rah1236/PCBGolf/pcbgolf.kicad_sch

## KiCad design pcbgolf.kicad_sch (2026-09-24)

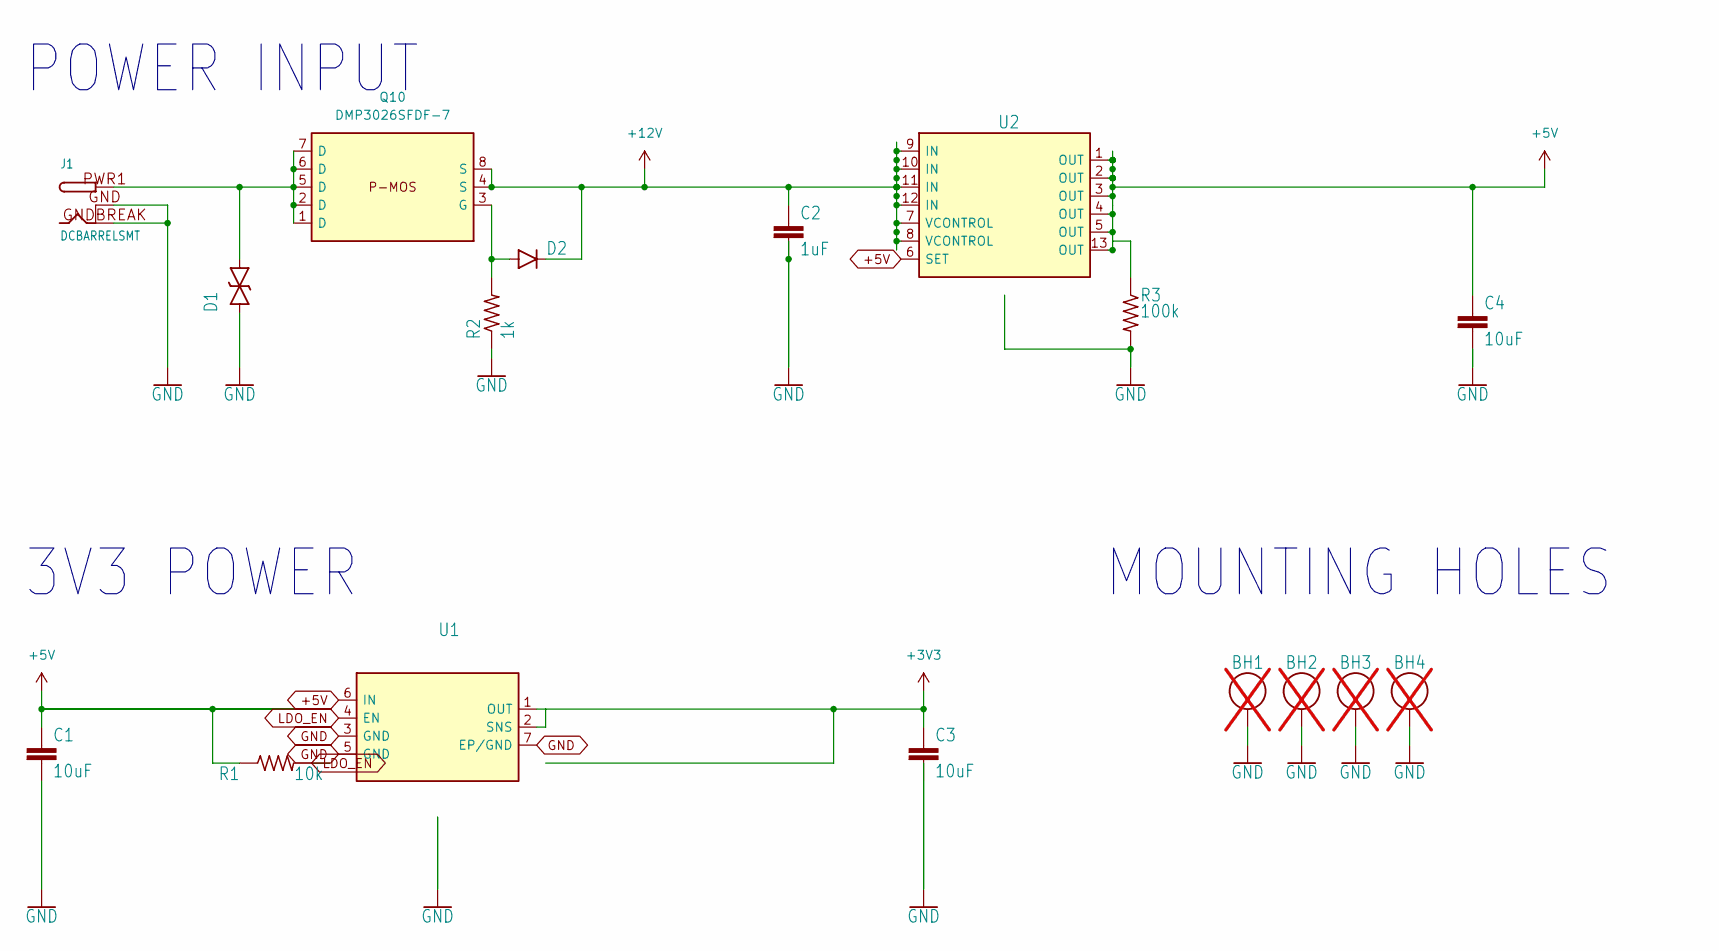
[picture p1: schematic pcbgolf.kicad_sch]

Parts:
BH1, BH2, BH3, BH4: M2_BOLT; not fitted
C1, C3, C4: 10uF; 0805-C; MPN CL21A106KAYNNNE
C2: 1uF; 0805-C; MPN CL21A106KAYNNNE
D1: TVS-BI-DO214AA; DO-214AA(SMB); MPN SMAJ16CA-13-F
D2: DIODEDB2W40100L; SOD-123F; MPN PMEG10020ELRX
J1: DCBARRELSMT; DCJACK_2MM_SMT; MPN PJ-002AH-SMT-TR
Q10: DMP3026SFDF-7; DMP3026SFDF-7_U-DFN2020-6; MPN DMP3026SFDF-7; LCSC Part C461076
R1: 10k; 0402-R; MPN RC0402FR-0710KL
R2: 1k; 0402-R; MPN RC0402JR-071KL
R3: 100k; 0402-R; MPN RC0100FR-07100KL
U1: TLV76733DRVR; WSON-6_L2.0-W2.0-P0.65-TL-EP; MPN TLV76733DRVR; LCSC Part C2848334
U2: LT3083IDF#TRPBF; DFN-12_L4.0-W4.0-P0.50-BL-EP; MPN LT3083IDF#TRPBF; LCSC Part C670355

Connections:
+3V3: C3.1, U1.1 (OUT), U1.2 (SNS)
+5V: C1.1, C4.1, R1.1, R3.1, U1.6 (IN), U2.1 (OUT), U2.2 (OUT), U2.3 (OUT), U2.4 (OUT), U2.5 (OUT), U2.6 (SET), U2.13 (OUT)
+12V: C2.1, D2.1 (C), Q10.4 (S), Q10.8 (S), U2.7 (VCONTROL), U2.8 (VCONTROL), U2.9 (IN), U2.10 (IN), U2.11 (IN), U2.12 (IN)
GND: BH1.0, BH2.0, BH3.0, BH4.0, C1.2, C2.2, C3.2, C4.2, D1.1, J1.GND (GNDBREAK), J1.GNDBREAK (GND), R2.1, R3.2, U1.3 (GND), U1.5 (GND), U1.7 (EP/GND)
LDO_EN: R1.2, U1.4 (EN)
unnamed: D1.2, J1.PWR1 (PWR), Q10.1 (D), Q10.2 (D), Q10.5 (D), Q10.6 (D), Q10.7 (D)
unnamed: D2.2 (A), Q10.3 (G), R2.2

Notes on the sheet:
MOUNTING HOLES
3V3 POWER
POWER INPUT
