rah1236/PCBGolf/pcbgolf_2.kicad_sch

## KiCad design pcbgolf_2.kicad_sch (2026-09-24)

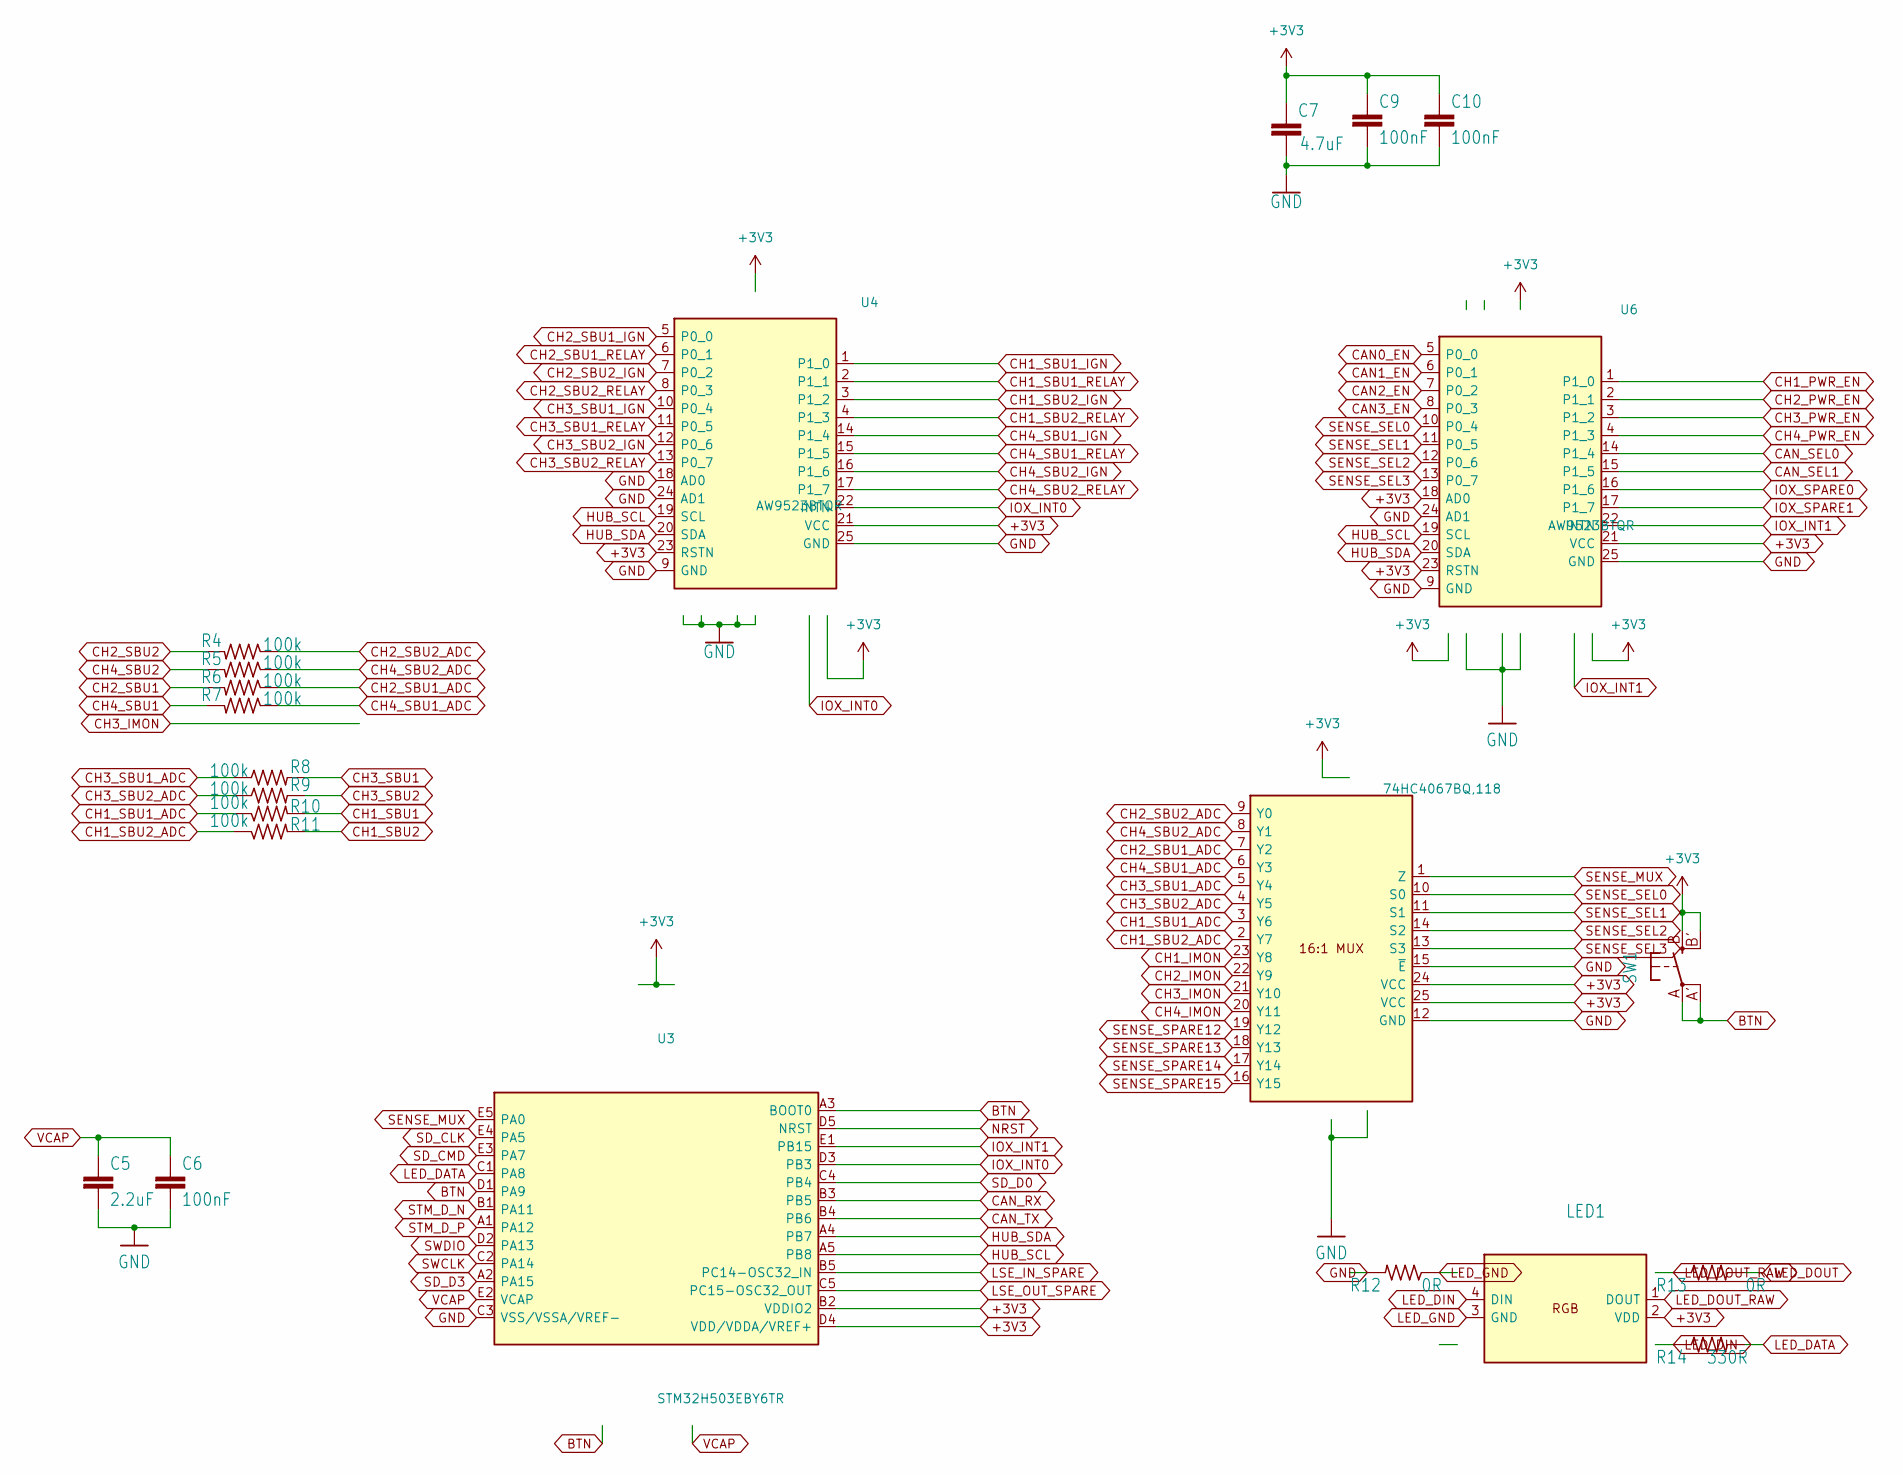
[picture p2: schematic pcbgolf_2.kicad_sch]

Parts:
C5: 2.2uF; 0805-C; MPN CL21A106KAYNNNE
C6, C9, C10: 100nF; 0402-C; MPN CL05F104ZO5NNNC
C7: 4.7uF; 0805-C; MPN CL21A106KAYNNNE
LED1: XL-1010RGBC-WS2812B; LED-SMD_4P-L1.0-W1.0-TL_XL-1010RGBC-WS2812B; MPN XL-1010RGBC-2812B; LCSC Part C5349953
R4, R5, R6, R7, R8, R9, R10, R11: 100k; 0402-R; MPN RC0402JR-07100KL
R12, R13: 0R; 0402-R; MPN RC0100JR-070RL
R14: 330R; 0402-R; MPN RC0100FR-07330RL
SW1: SPST-2-4PIN; EVQ-Q2; MPN EVQ-Q2Y03W
U3: STM32H503EBY6TR; WLCSP-25_L2.3-W2.2-R5-C5-P0.40-BR; MPN STM32H503EBY6TR; LCSC Part C26803530
U4, U6: AW9523BTQR; VFQFPN-24_L4.0-W4.0-P0.50-BL-EP2.8; MPN AW9523BTQR; LCSC Part C148077
U5: 74HC4067BQ,118; DHVQFN24_L5.5-W3.5-P0.50-BL-EP; MPN 74HC4067BQ,118; LCSC Part C547033

Connections:
+3V3: C7.1, C9.1, C10.1, LED1.2 (VDD), SW1.B (S), SW1.B' (S1), U3.B2 (VDDIO2), U3.D4 (VDD/VDDA/VREF+), U4.21 (VCC), U4.23 (RSTN), U5.24 (VCC), U5.25 (VCC), U6.18 (AD0), U6.21 (VCC), U6.23 (RSTN)
BTN: SW1.A, SW1.A' (P1), U3.A3 (BOOT0), U3.D1 (PA9)
CAN0_EN: U6.5 (P0_0)
CAN1_EN: U6.6 (P0_1)
CAN2_EN: U6.7 (P0_2)
CAN3_EN: U6.8 (P0_3)
CAN_RX: U3.B3 (PB5)
CAN_SEL0: U6.14 (P1_4)
CAN_SEL1: U6.15 (P1_5)
CAN_TX: U3.B4 (PB6)
CH1_IMON: U5.23 (Y8)
CH1_PWR_EN: U6.1 (P1_0)
CH1_SBU1: R10.2
CH1_SBU1_ADC: R10.1, U5.3 (Y6)
CH1_SBU1_IGN: U4.1 (P1_0)
CH1_SBU1_RELAY: U4.2 (P1_1)
CH1_SBU2: R11.2
CH1_SBU2_ADC: R11.1, U5.2 (Y7)
CH1_SBU2_IGN: U4.3 (P1_2)
CH1_SBU2_RELAY: U4.4 (P1_3)
CH2_IMON: U5.22 (Y9)
CH2_PWR_EN: U6.2 (P1_1)
CH2_SBU1: R6.2
CH2_SBU1_ADC: R6.1, U5.7 (Y2)
CH2_SBU1_IGN: U4.5 (P0_0)
CH2_SBU1_RELAY: U4.6 (P0_1)
CH2_SBU2: R4.2
CH2_SBU2_ADC: R4.1, U5.9 (Y0)
CH2_SBU2_IGN: U4.7 (P0_2)
CH2_SBU2_RELAY: U4.8 (P0_3)
CH3_IMON: U5.21 (Y10)
CH3_PWR_EN: U6.3 (P1_2)
CH3_SBU1: R8.2
CH3_SBU1_ADC: R8.1, U5.5 (Y4)
CH3_SBU1_IGN: U4.10 (P0_4)
CH3_SBU1_RELAY: U4.11 (P0_5)
CH3_SBU2: R9.2
CH3_SBU2_ADC: R9.1, U5.4 (Y5)
CH3_SBU2_IGN: U4.12 (P0_6)
CH3_SBU2_RELAY: U4.13 (P0_7)
CH4_IMON: U5.20 (Y11)
CH4_PWR_EN: U6.4 (P1_3)
CH4_SBU1: R7.2
CH4_SBU1_ADC: R7.1, U5.6 (Y3)
CH4_SBU1_IGN: U4.14 (P1_4)
CH4_SBU1_RELAY: U4.15 (P1_5)
CH4_SBU2: R5.2
CH4_SBU2_ADC: R5.1, U5.8 (Y1)
CH4_SBU2_IGN: U4.16 (P1_6)
CH4_SBU2_RELAY: U4.17 (P1_7)
GND: C5.2, C6.2, C7.2, C9.2, C10.2, R12.2, U3.C3 (VSS/VSSA/VREF-), U4.9 (GND), U4.18 (AD0), U4.24 (AD1), U4.25 (GND), U5.12 (GND), U5.15 (~E), U6.9 (GND), U6.24 (AD1), U6.25 (GND)
HUB_SCL: U3.A5 (PB8), U4.19 (SCL), U6.19 (SCL)
HUB_SDA: U3.A4 (PB7), U4.20 (SDA), U6.20 (SDA)
IOX_INT0: U3.D3 (PB3), U4.22 (INTN)
IOX_INT1: U3.E1 (PB15), U6.22 (INTN)
IOX_SPARE0: U6.16 (P1_6)
IOX_SPARE1: U6.17 (P1_7)
LED_DATA: R14.2, U3.C1 (PA8)
LED_DIN: LED1.4 (DIN), R14.1
LED_DOUT: R13.2
LED_DOUT_RAW: LED1.1 (DOUT), R13.1
LED_GND: LED1.3 (GND), R12.1
LSE_IN_SPARE: U3.B5 (PC14-OSC32_IN)
LSE_OUT_SPARE: U3.C5 (PC15-OSC32_OUT)
NRST: U3.D5 (NRST)
SD_CLK: U3.E4 (PA5)
SD_CMD: U3.E3 (PA7)
SD_D0: U3.C4 (PB4)
SD_D3: U3.A2 (PA15)
SENSE_MUX: U3.E5 (PA0), U5.1 (Z)
SENSE_SEL0: U5.10 (S0), U6.10 (P0_4)
SENSE_SEL1: U5.11 (S1), U6.11 (P0_5)
SENSE_SEL2: U5.14 (S2), U6.12 (P0_6)
SENSE_SEL3: U5.13 (S3), U6.13 (P0_7)
SENSE_SPARE12: U5.19 (Y12)
SENSE_SPARE13: U5.18 (Y13)
SENSE_SPARE14: U5.17 (Y14)
SENSE_SPARE15: U5.16 (Y15)
STM_D_N: U3.B1 (PA11)
STM_D_P: U3.A1 (PA12)
SWCLK: U3.C2 (PA14)
SWDIO: U3.D2 (PA13)
VCAP: C5.1, C6.1, U3.E2 (VCAP)
