rah1236/PCBGolf/pcbgolf_3.kicad_sch

## KiCad design pcbgolf_3.kicad_sch (2026-09-24)

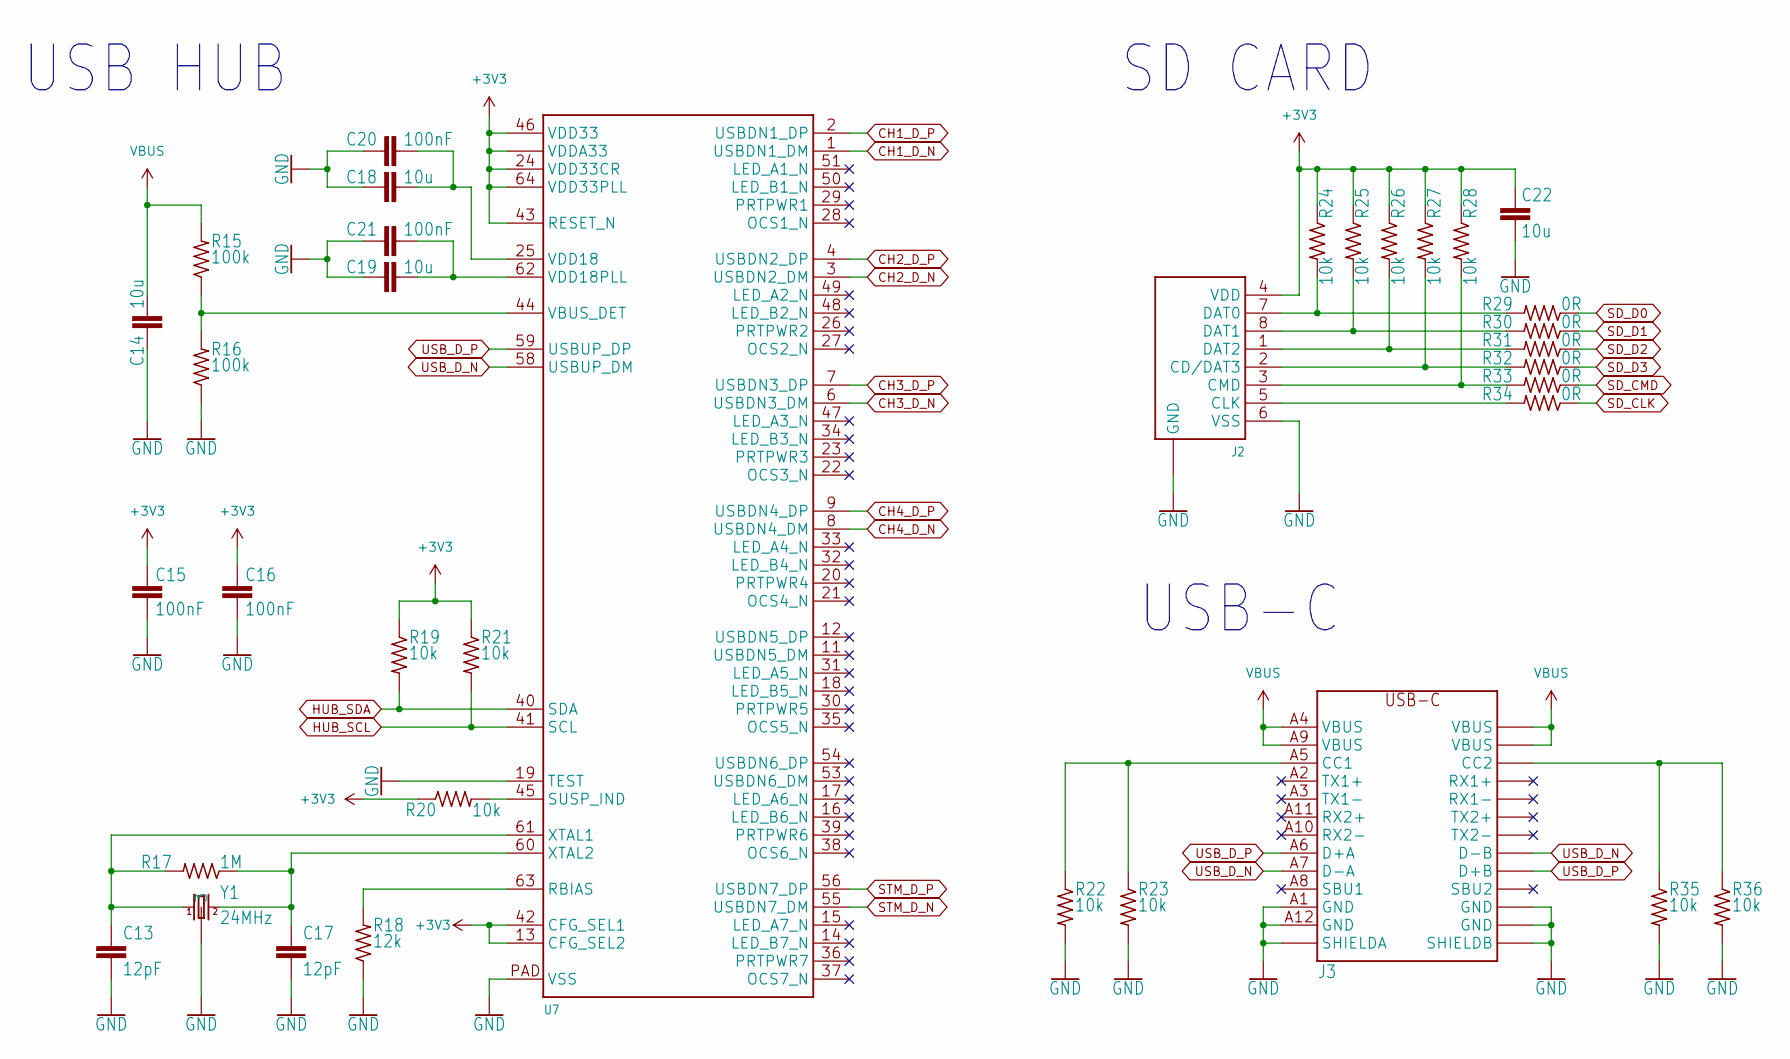
[picture p3: schematic pcbgolf_3.kicad_sch]

Parts:
C13, C17: 12pF; 0402-C; MPN C0402C120J5GACTU
C14, C18, C19, C22: 10u; 0402-C; MPN GRM155R61A106ME11D
C15, C16, C20, C21: 100nF; 0402-C; MPN CL05F104ZO5NNNC
J2: MICRO_SD-0472192001; 0472192001; MPN 47219-2001
J3: USB-C-FEMALE; DX07S024XJ1R1100; MPN DX07S024XJ1R1100
R15, R16: 100k; 0402-R; MPN RC0402JR-07100KL
R17: 1M; 0402-R; MPN RC0402JR-071ML
R18: 12k; 0402-R; MPN CRGCQ0402F12K
R19, R20, R21, R22, R23, R24, R25, R26, R27, R28, R35, R36: 10k; 0402-R; MPN RC0402FR-0710KL
R29, R30, R31, R32, R33, R34: 0R; 0402-R; MPN RMCF0402ZT0R00
U7: USB2517; QFN64-9X9; MPN USB2517
Y1: 24MHz; XTAL-3.2X2.5; MPN ABM8AIG-24.000MHZ-12-2Z-T3

Connections:
+3V3: C15.2, C16.2, C22.1, J2.4 (VDD), R19.1, R20.1, R21.1, R24.1, R25.1, R26.1, R27.1, R28.1, U7.5 (VDDA33), U7.10 (VDDA33), U7.13 (CFG_SEL2), U7.24 (VDD33CR), U7.42 (CFG_SEL1), U7.43 (RESET_N), U7.46 (VDD33), U7.52 (VDDA33), U7.57 (VDDA33), U7.64 (VDD33PLL)
CH1_D_N: U7.1 (USBDN1_DM)
CH1_D_P: U7.2 (USBDN1_DP)
CH2_D_N: U7.3 (USBDN2_DM)
CH2_D_P: U7.4 (USBDN2_DP)
CH3_D_N: U7.6 (USBDN3_DM)
CH3_D_P: U7.7 (USBDN3_DP)
CH4_D_N: U7.8 (USBDN4_DM)
CH4_D_P: U7.9 (USBDN4_DP)
GND: C13.2, C14.2, C15.1, C16.1, C17.2, C18.2, C19.2, C20.1, C21.1, C22.2, J2.6 (VSS), J2.G1 (GND), J2.G2 (GND), J2.G3 (GND), J2.G4 (GND), J3.A1 (GND), J3.A12 (GND), J3.B1 (GND), J3.B1T (GND), J3.B12 (GND), J3.B12T (GND), J3.S1B (SHIELDA), J3.S1T (SHIELDA), J3.S1TH (SHIELDA), J3.S2B (SHIELDA), J3.S2T (SHIELDA), J3.S2TH (SHIELDA), J3.S3B (SHIELDB), J3.S3T (SHIELDB), J3.S3TH (SHIELDB), J3.S4B (SHIELDB), J3.S4T (SHIELDB), J3.S4TH (SHIELDB), R16.1, R18.1, R22.2, R23.2, R35.2, R36.2, U7.19 (TEST), U7.PAD (VSS), Y1.2 (3), Y1.4 (3)
HUB_SCL: R21.2, U7.41 (SCL)
HUB_SDA: R19.2, U7.40 (SDA)
unnamed: C13.1, R17.2, U7.61 (XTAL1), Y1.1
unnamed: C17.1, R17.1, U7.60 (XTAL2), Y1.3 (2)
unnamed: C18.1, C20.2, U7.25 (VDD18)
unnamed: C19.1, C21.2, U7.62 (VDD18PLL)
unnamed: J2.1 (DAT2), R26.2, R31.2
unnamed: J2.2 (CD/DAT3), R27.2, R32.2
unnamed: J2.3 (CMD), R28.2, R33.2
unnamed: J2.5 (CLK), R34.2
unnamed: J2.7 (DAT0), R24.2, R29.2
unnamed: J2.8 (DAT1), R25.2, R30.2
unnamed: J3.A5 (CC1), R22.1, R23.1
unnamed: J3.B2 (TX2+), J3.B2T (TX2+)
unnamed: J3.B3 (TX2-), J3.B3T (TX2-)
unnamed: J3.B5 (CC2), J3.B5T (CC2), R35.1, R36.1
unnamed: J3.B8 (SBU2), J3.B8T (SBU2)
unnamed: J3.B10 (RX1-), J3.B10T (RX1-)
unnamed: J3.B11 (RX1+), J3.B11T (RX1+)
unnamed: R15.1, R16.2, U7.44 (VBUS_DET)
unnamed: R18.2, U7.63 (RBIAS)
unnamed: R20.2, U7.45 (SUSP_IND)
SD_CLK: R34.1
SD_CMD: R33.1
SD_D0: R29.1
SD_D1: R30.1
SD_D2: R31.1
SD_D3: R32.1
STM_D_N: U7.55 (USBDN7_DM)
STM_D_P: U7.56 (USBDN7_DP)
USB_D_N: J3.A7 (D-A), J3.B7 (D-B), J3.B7T (D-B), U7.58 (USBUP_DM)
USB_D_P: J3.A6 (D+A), J3.B6 (D+B), J3.B6T (D+B), U7.59 (USBUP_DP)
VBUS: C14.1, J3.A4 (VBUS), J3.A9 (VBUS), J3.B4 (VBUS), J3.B4T (VBUS), J3.B9 (VBUS), J3.B9T (VBUS), R15.2

Notes on the sheet:
SD CARD
USB-C
USB HUB
