rah1236/PCBGolf/pcbgolf_4.kicad_sch

## KiCad design pcbgolf_4.kicad_sch (2026-09-24)

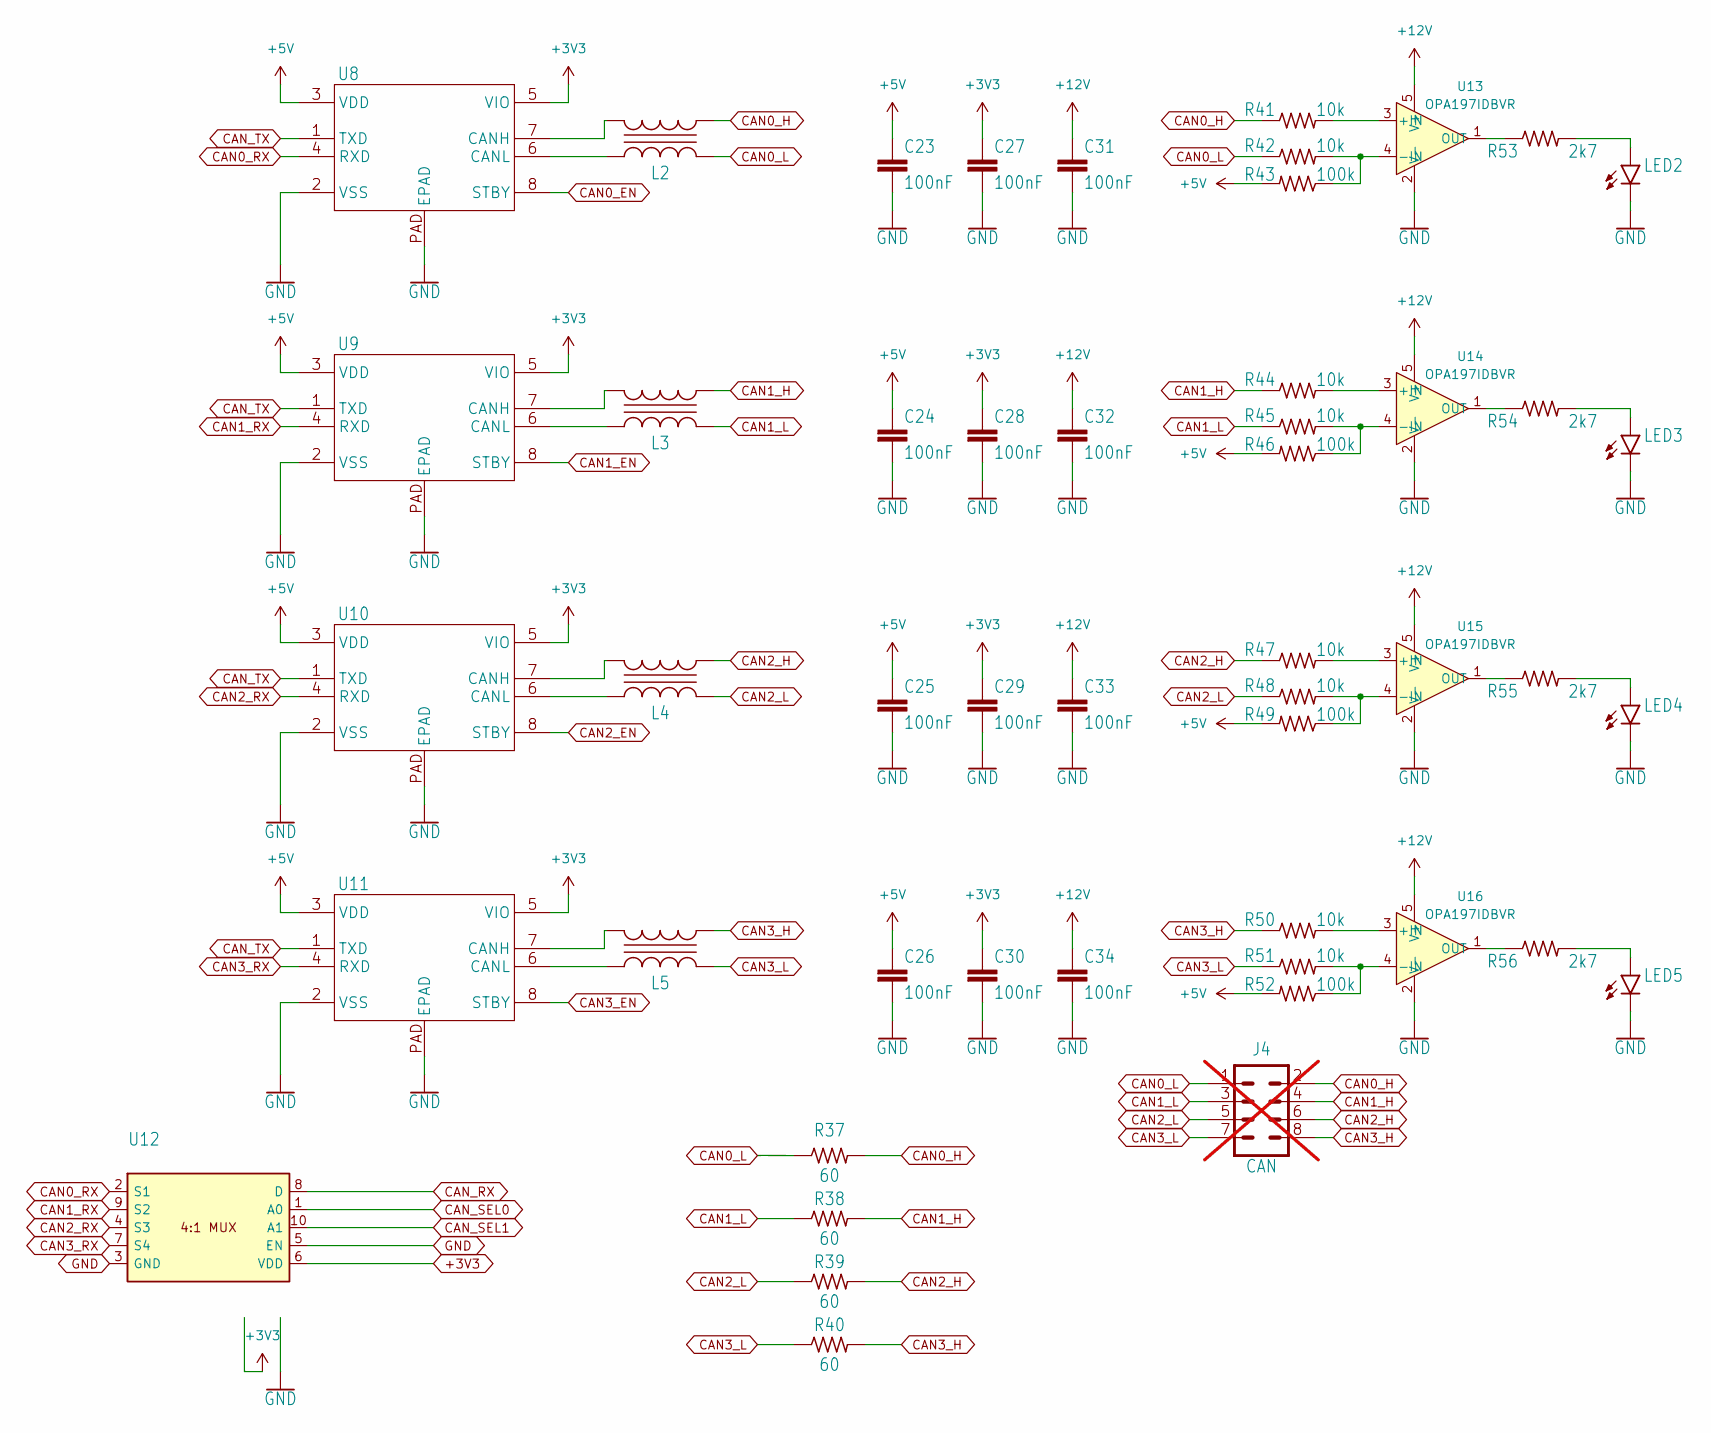
[picture p4: schematic pcbgolf_4.kicad_sch]

Parts:
C23, C24, C25, C26, C27, C28, C29, C30, C31, C32, C33, C34: 100nF; 0402-C; MPN CL05F104ZO5NNNC
J4: CAN; 2X04; not fitted
L2, L3, L4, L5: ACT1210D_CHOKE; CHOKE-3.2X2.5; MPN ACT1210D-101-2P-TL00
LED2, LED3, LED4, LED5: APG015ZGC/S-5MAV; Kingbright_APG015_01005; MPN APG015ZGC/S-5MAV
R37, R38, R39, R40: 60; 0402-R; MPN RC0402FR-0760R4L
R41, R42, R44, R45, R47, R48, R50, R51: 10k; 0402-R; MPN RC0402FR-0710KL
R43, R46, R49, R52: 100k; 0402-R; MPN RC0402JR-07100KL
R53, R54, R55, R56: 2k7; 0402-R; MPN RC0402JR-072K7L
U8, U9, U10, U11: MCP2542FDT-E/MNY; TDFN8_2X3MC_MCH; MPN MCP2542FDT-H/MNY
U12: TMUX1204DQAR; USON-10_L2.5-W1.0-P0.50-BL; MPN TMUX1204DQAR; LCSC Part C1849379
U13, U14, U15, U16: OPA197IDBVR; SOT23-5; MPN OPA197IDBVR

Connections:
+3V3: C27.1, C28.1, C29.1, C30.1, U8.5 (VIO), U9.5 (VIO), U10.5 (VIO), U11.5 (VIO), U12.6 (VDD)
+5V: C23.1, C24.1, C25.1, C26.1, R43.2, R46.2, R49.2, R52.2, U8.3 (VDD), U9.3 (VDD), U10.3 (VDD), U11.3 (VDD)
+12V: C31.1, C32.1, C33.1, C34.1, U13.5 (V+), U14.5 (V+), U15.5 (V+), U16.5 (V+)
CAN0_EN: U8.8 (STBY)
CAN0_H: J4.2, L2.4, R37.2, R41.1
CAN0_L: J4.1, L2.3, R37.1, R42.1
CAN0_RX: U8.4 (RXD), U12.2 (S1)
CAN1_EN: U9.8 (STBY)
CAN1_H: J4.4, L3.4, R38.2, R44.1
CAN1_L: J4.3, L3.3, R38.1, R45.1
CAN1_RX: U9.4 (RXD), U12.9 (S2)
CAN2_EN: U10.8 (STBY)
CAN2_H: J4.6, L4.4, R39.2, R47.1
CAN2_L: J4.5, L4.3, R39.1, R48.1
CAN2_RX: U10.4 (RXD), U12.4 (S3)
CAN3_EN: U11.8 (STBY)
CAN3_H: J4.8, L5.4, R40.2, R50.1
CAN3_L: J4.7, L5.3, R40.1, R51.1
CAN3_RX: U11.4 (RXD), U12.7 (S4)
CAN_RX: U12.8 (D)
CAN_SEL0: U12.1 (A0)
CAN_SEL1: U12.10 (A1)
CAN_TX: U8.1 (TXD), U9.1 (TXD), U10.1 (TXD), U11.1 (TXD)
GND: C23.2, C24.2, C25.2, C26.2, C27.2, C28.2, C29.2, C30.2, C31.2, C32.2, C33.2, C34.2, LED2.1 (K), LED3.1 (K), LED4.1 (K), LED5.1 (K), U8.2 (VSS), U8.PAD (EPAD), U9.2 (VSS), U9.PAD (EPAD), U10.2 (VSS), U10.PAD (EPAD), U11.2 (VSS), U11.PAD (EPAD), U12.3 (GND), U12.5 (EN), U13.2 (V-), U14.2 (V-), U15.2 (V-), U16.2 (V-)
unnamed: L2.1, U8.7 (CANH)
unnamed: L2.2, U8.6 (CANL)
unnamed: L3.1, U9.7 (CANH)
unnamed: L3.2, U9.6 (CANL)
unnamed: L4.1, U10.7 (CANH)
unnamed: L4.2, U10.6 (CANL)
unnamed: L5.1, U11.7 (CANH)
unnamed: L5.2, U11.6 (CANL)
unnamed: LED2.2 (A), R53.2
unnamed: LED3.2 (A), R54.2
unnamed: LED4.2 (A), R55.2
unnamed: LED5.2 (A), R56.2
unnamed: R41.2, U13.3 (+IN)
unnamed: R42.2, R43.1, U13.4 (-IN)
unnamed: R44.2, U14.3 (+IN)
unnamed: R45.2, R46.1, U14.4 (-IN)
unnamed: R47.2, U15.3 (+IN)
unnamed: R48.2, R49.1, U15.4 (-IN)
unnamed: R50.2, U16.3 (+IN)
unnamed: R51.2, R52.1, U16.4 (-IN)
unnamed: R53.1, U13.1 (OUT)
unnamed: R54.1, U14.1 (OUT)
unnamed: R55.1, U15.1 (OUT)
unnamed: R56.1, U16.1 (OUT)
