rah1236/PCBGolf/pcbgolf_5.kicad_sch

## KiCad design pcbgolf_5.kicad_sch (2026-09-24)

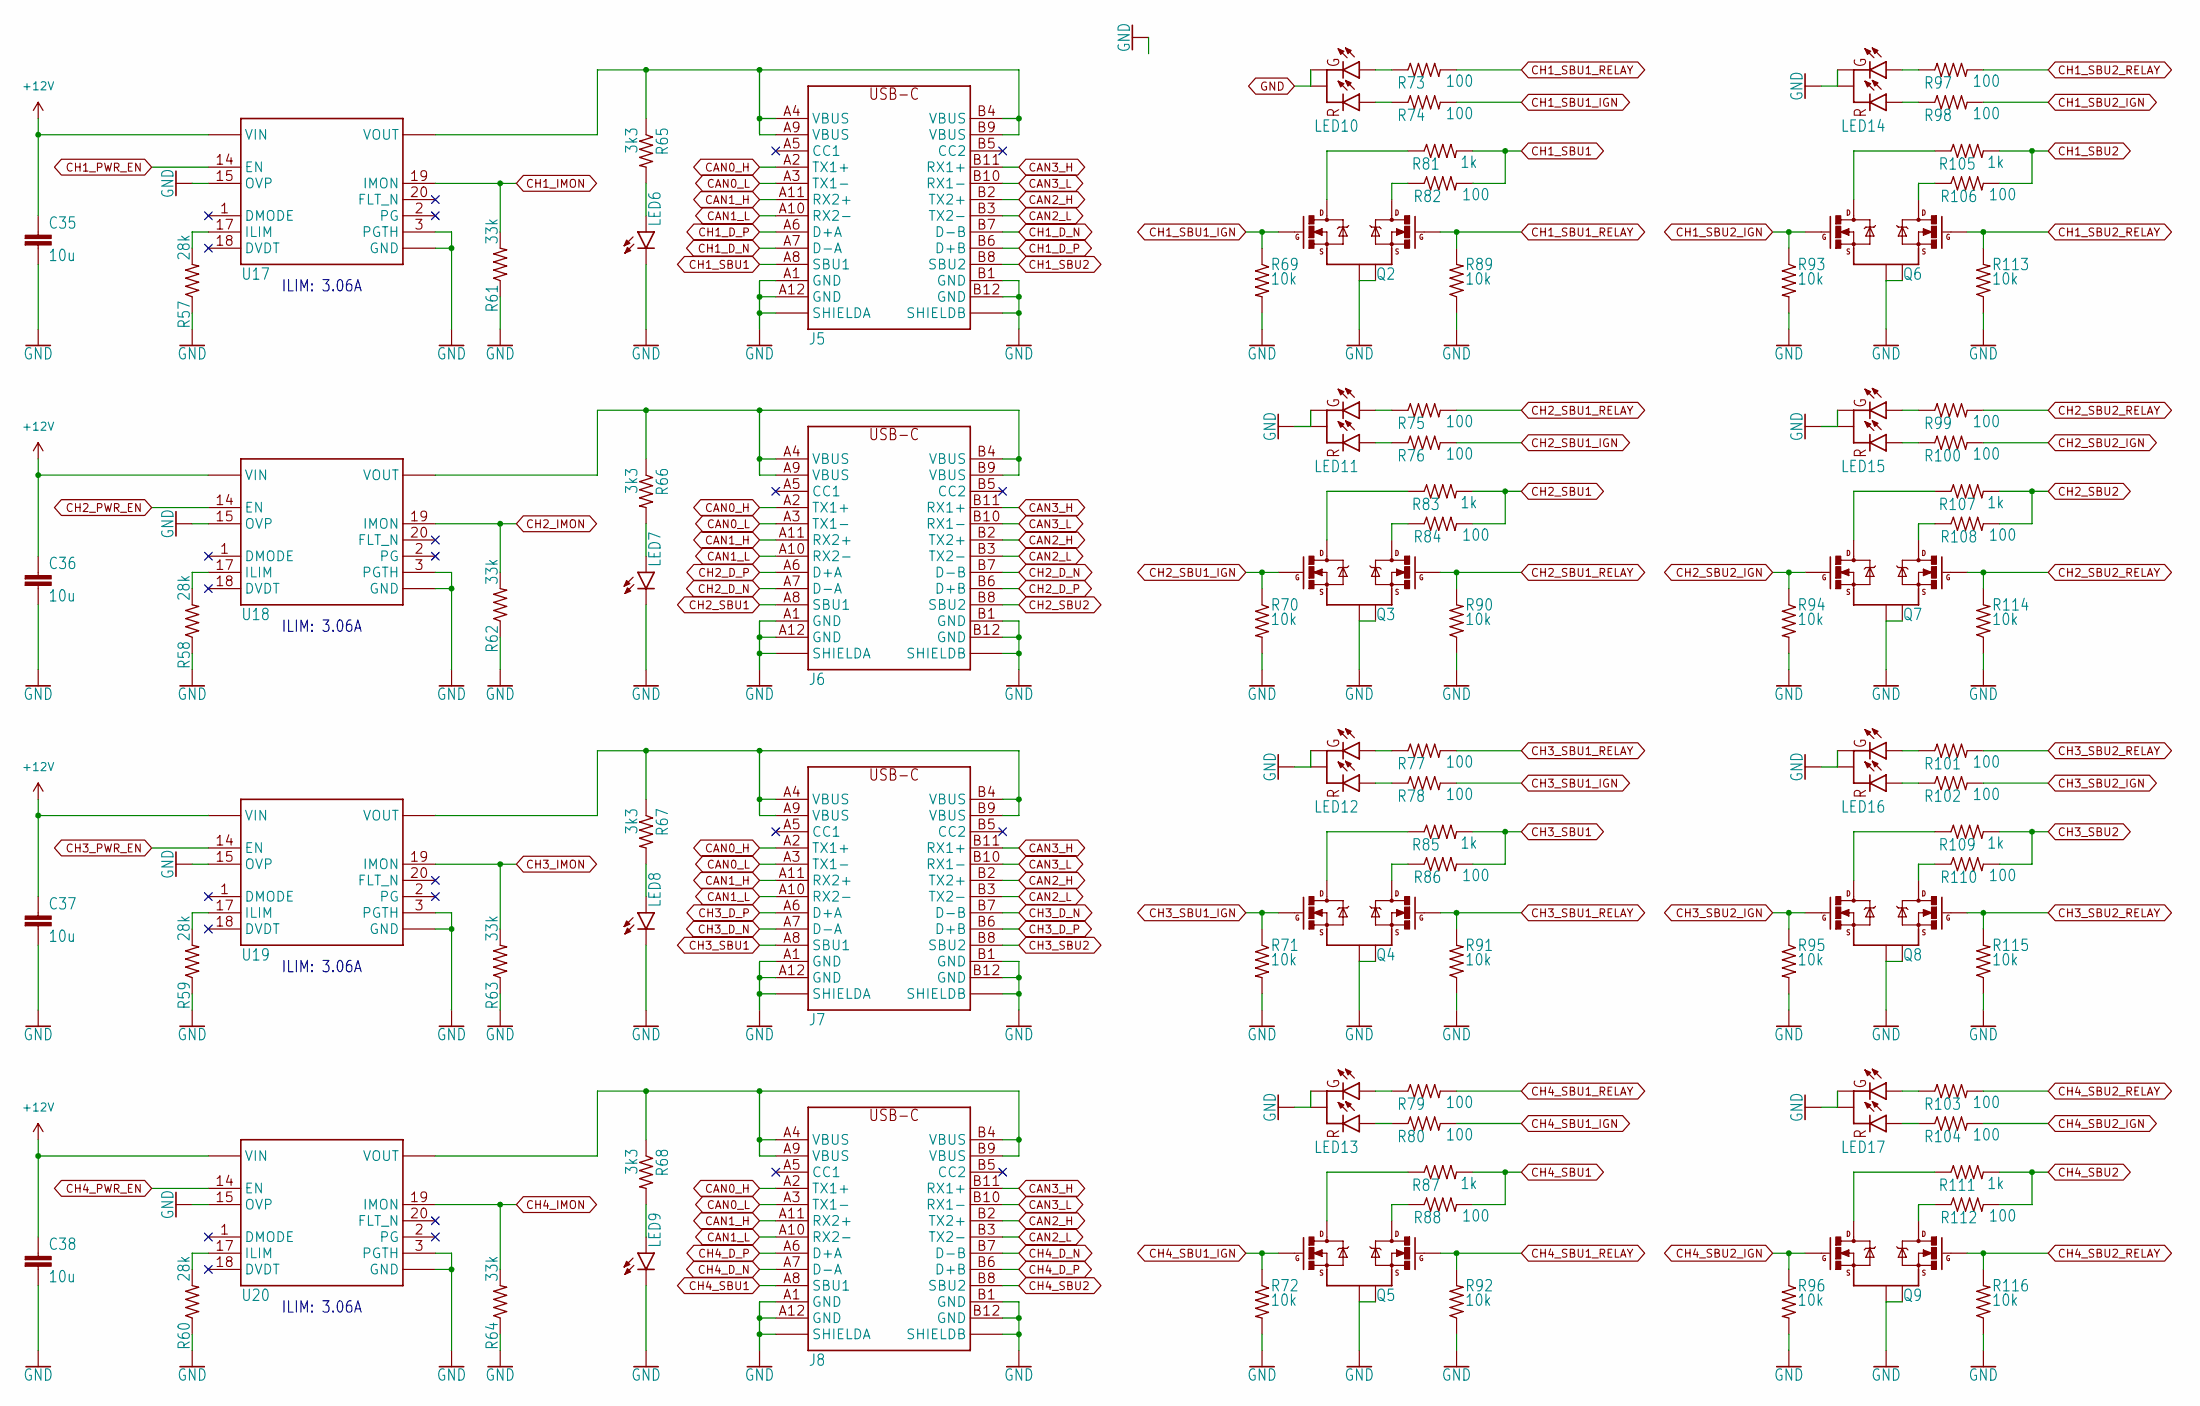
[picture p5: schematic pcbgolf_5.kicad_sch]

Parts:
C35, C36, C37, C38: 10u; 0805-C; MPN CL21A106KAYNNNE
J5, J6, J7, J8: USB-C-FEMALEGCT; USB-C-FEMALE-VERT-GCT; MPN 10132328-10011LF
LED6, LED7, LED8, LED9: APG015ZGC/S-5MAV; Kingbright_APG015_01005; MPN APG015ZGC/S-5MAV
LED10, LED11, LED12, LED13, LED14, LED15, LED16, LED17: APTB1612ESGC-F01; Kingbright_APTB1612ESGC-F01; MPN APTB1612ESGC-F01
Q2, Q3, Q4, Q5, Q6, Q7, Q8, Q9: AON2812; AON2812_DFN2x2A_6L_EP2_S; MPN AON2812
R57, R58, R59, R60: 28k; 0402-R; MPN RK73H1ETTP2802F
R61, R62, R63, R64: 33k; 0402-R; MPN RC0402JR-0733KL
R65, R66, R67, R68: 3k3; 0402-R; MPN RC0402JR-073K3L
R69, R70, R71, R72, R89, R90, R91, R92, R93, R94, R95, R96, R113, R114, R115, R116: 10k; 0402-R; MPN RC0402FR-0710KL
R73, R74, R75, R76, R77, R78, R79, R80, R82, R84, R86, R88, R97, R98, R99, R100, R101, R102, R103, R104, R106, R108, R110, R112: 100; 0402-R; MPN RC0402JR-07100RL
R81, R83, R85, R87, R105, R107, R109, R111: 1k; 0402-R; MPN RC0402JR-071KL
U17, U18, U19, U20: TPS25942; WQFN20; MPN TPS25944ARVCR

Connections:
+12V: C35.1, C36.1, C37.1, C38.1, U17.9 (VIN), U17.10 (VIN), U17.11 (VIN), U17.12 (VIN), U17.13 (VIN), U18.9 (VIN), U18.10 (VIN), U18.11 (VIN), U18.12 (VIN), U18.13 (VIN), U19.9 (VIN), U19.10 (VIN), U19.11 (VIN), U19.12 (VIN), U19.13 (VIN), U20.9 (VIN), U20.10 (VIN), U20.11 (VIN), U20.12 (VIN), U20.13 (VIN)
CAN0_H: J5.A2 (TX1+), J6.A2 (TX1+), J7.A2 (TX1+), J8.A2 (TX1+)
CAN0_L: J5.A3 (TX1-), J6.A3 (TX1-), J7.A3 (TX1-), J8.A3 (TX1-)
CAN1_H: J5.A11 (RX2+), J6.A11 (RX2+), J7.A11 (RX2+), J8.A11 (RX2+)
CAN1_L: J5.A10 (RX2-), J6.A10 (RX2-), J7.A10 (RX2-), J8.A10 (RX2-)
CAN2_H: J5.B2 (TX2+), J6.B2 (TX2+), J7.B2 (TX2+), J8.B2 (TX2+)
CAN2_L: J5.B3 (TX2-), J6.B3 (TX2-), J7.B3 (TX2-), J8.B3 (TX2-)
CAN3_H: J5.B11 (RX1+), J6.B11 (RX1+), J7.B11 (RX1+), J8.B11 (RX1+)
CAN3_L: J5.B10 (RX1-), J6.B10 (RX1-), J7.B10 (RX1-), J8.B10 (RX1-)
CH1_D_N: J5.A7 (D-A), J5.B7 (D-B)
CH1_D_P: J5.A6 (D+A), J5.B6 (D+B)
CH1_IMON: R61.2, U17.19 (IMON)
CH1_PWR_EN: U17.14 (EN)
CH1_SBU1: J5.A8 (SBU1), R81.2, R82.2
CH1_SBU1_IGN: Q2.2 (G1), R69.1, R74.2
CH1_SBU1_RELAY: Q2.5 (G2), R73.2, R89.2
CH1_SBU2: J5.B8 (SBU2), R105.2, R106.2
CH1_SBU2_IGN: Q6.2 (G1), R93.1, R98.2
CH1_SBU2_RELAY: Q6.5 (G2), R97.2, R113.2
CH2_D_N: J6.A7 (D-A), J6.B7 (D-B)
CH2_D_P: J6.A6 (D+A), J6.B6 (D+B)
CH2_IMON: R62.2, U18.19 (IMON)
CH2_PWR_EN: U18.14 (EN)
CH2_SBU1: J6.A8 (SBU1), R83.2, R84.2
CH2_SBU1_IGN: Q3.2 (G1), R70.1, R76.2
CH2_SBU1_RELAY: Q3.5 (G2), R75.2, R90.2
CH2_SBU2: J6.B8 (SBU2), R107.2, R108.2
CH2_SBU2_IGN: Q7.2 (G1), R94.1, R100.2
CH2_SBU2_RELAY: Q7.5 (G2), R99.2, R114.2
CH3_D_N: J7.A7 (D-A), J7.B7 (D-B)
CH3_D_P: J7.A6 (D+A), J7.B6 (D+B)
CH3_IMON: R63.2, U19.19 (IMON)
CH3_PWR_EN: U19.14 (EN)
CH3_SBU1: J7.A8 (SBU1), R85.2, R86.2
CH3_SBU1_IGN: Q4.2 (G1), R71.1, R78.2
CH3_SBU1_RELAY: Q4.5 (G2), R77.2, R91.2
CH3_SBU2: J7.B8 (SBU2), R109.2, R110.2
CH3_SBU2_IGN: Q8.2 (G1), R95.1, R102.2
CH3_SBU2_RELAY: Q8.5 (G2), R101.2, R115.2
CH4_D_N: J8.A7 (D-A), J8.B7 (D-B)
CH4_D_P: J8.A6 (D+A), J8.B6 (D+B)
CH4_IMON: R64.2, U20.19 (IMON)
CH4_PWR_EN: U20.14 (EN)
CH4_SBU1: J8.A8 (SBU1), R87.2, R88.2
CH4_SBU1_IGN: Q5.2 (G1), R72.1, R80.2
CH4_SBU1_RELAY: Q5.5 (G2), R79.2, R92.2
CH4_SBU2: J8.B8 (SBU2), R111.2, R112.2
CH4_SBU2_IGN: Q9.2 (G1), R96.1, R104.2
CH4_SBU2_RELAY: Q9.5 (G2), R103.2, R116.2
GND: C35.2, C36.2, C37.2, C38.2, J5.A1 (GND), J5.A12 (GND), J5.B1 (GND), J5.B12 (GND), J5.S1 (SHIELDA), J5.S2 (SHIELDA), J5.S3 (SHIELDA), J5.S4 (SHIELDA), J5.S11 (SHIELDB), J5.S12 (SHIELDB), J5.S13 (SHIELDB), J5.S14 (SHIELDB), J6.A1 (GND), J6.A12 (GND), J6.B1 (GND), J6.B12 (GND), J6.S1 (SHIELDA), J6.S2 (SHIELDA), J6.S3 (SHIELDA), J6.S4 (SHIELDA), J6.S11 (SHIELDB), J6.S12 (SHIELDB), J6.S13 (SHIELDB), J6.S14 (SHIELDB), J7.A1 (GND), J7.A12 (GND), J7.B1 (GND), J7.B12 (GND), J7.S1 (SHIELDA), J7.S2 (SHIELDA), J7.S3 (SHIELDA), J7.S4 (SHIELDA), J7.S11 (SHIELDB), J7.S12 (SHIELDB), J7.S13 (SHIELDB), J7.S14 (SHIELDB), J8.A1 (GND), J8.A12 (GND), J8.B1 (GND), J8.B12 (GND), J8.S1 (SHIELDA), J8.S2 (SHIELDA), J8.S3 (SHIELDA), J8.S4 (SHIELDA), J8.S11 (SHIELDB), J8.S12 (SHIELDB), J8.S13 (SHIELDB), J8.S14 (SHIELDB), LED6.1 (K), LED7.1 (K), LED8.1 (K), LED9.1 (K), LED10.2 (R_K), LED10.4 (G_K), LED11.2 (R_K), LED11.4 (G_K), LED12.2 (R_K), LED12.4 (G_K), LED13.2 (R_K), LED13.4 (G_K), LED14.2 (R_K), LED14.4 (G_K), LED15.2 (R_K), LED15.4 (G_K), LED16.2 (R_K), LED16.4 (G_K), LED17.2 (R_K), LED17.4 (G_K), Q2.1 (S1), Q2.4 (S2), Q3.1 (S1), Q3.4 (S2), Q4.1 (S1), Q4.4 (S2), Q5.1 (S1), Q5.4 (S2), Q6.1 (S1), Q6.4 (S2), Q7.1 (S1), Q7.4 (S2), Q8.1 (S1), Q8.4 (S2), Q9.1 (S1), Q9.4 (S2), R57.1, R58.1, R59.1, R60.1, R61.1, R62.1, R63.1, R64.1, R69.2, R70.2, R71.2, R72.2, R89.1, R90.1, R91.1, R92.1, R93.2, R94.2, R95.2, R96.2, R113.1, R114.1, R115.1, R116.1, U17.3 (PGTH), U17.15 (OVP), U17.16 (GND), U17.PAD (GND), U18.3 (PGTH), U18.15 (OVP), U18.16 (GND), U18.PAD (GND), U19.3 (PGTH), U19.15 (OVP), U19.16 (GND), U19.PAD (GND), U20.3 (PGTH), U20.15 (OVP), U20.16 (GND), U20.PAD (GND)
unnamed: J5.A4 (VBUS), J5.A9 (VBUS), J5.B4 (VBUS), J5.B9 (VBUS), R65.1, U17.4 (VOUT), U17.5 (VOUT), U17.6 (VOUT), U17.7 (VOUT), U17.8 (VOUT)
unnamed: J6.A4 (VBUS), J6.A9 (VBUS), J6.B4 (VBUS), J6.B9 (VBUS), R66.1, U18.4 (VOUT), U18.5 (VOUT), U18.6 (VOUT), U18.7 (VOUT), U18.8 (VOUT)
unnamed: J7.A4 (VBUS), J7.A9 (VBUS), J7.B4 (VBUS), J7.B9 (VBUS), R67.1, U19.4 (VOUT), U19.5 (VOUT), U19.6 (VOUT), U19.7 (VOUT), U19.8 (VOUT)
unnamed: J8.A4 (VBUS), J8.A9 (VBUS), J8.B4 (VBUS), J8.B9 (VBUS), R68.1, U20.4 (VOUT), U20.5 (VOUT), U20.6 (VOUT), U20.7 (VOUT), U20.8 (VOUT)
unnamed: LED6.2 (A), R65.2
unnamed: LED7.2 (A), R66.2
unnamed: LED8.2 (A), R67.2
unnamed: LED9.2 (A), R68.2
unnamed: LED10.1 (R_A), R74.1
unnamed: LED10.3 (G_A), R73.1
unnamed: LED11.1 (R_A), R76.1
unnamed: LED11.3 (G_A), R75.1
unnamed: LED12.1 (R_A), R78.1
unnamed: LED12.3 (G_A), R77.1
unnamed: LED13.1 (R_A), R80.1
unnamed: LED13.3 (G_A), R79.1
unnamed: LED14.1 (R_A), R98.1
unnamed: LED14.3 (G_A), R97.1
unnamed: LED15.1 (R_A), R100.1
unnamed: LED15.3 (G_A), R99.1
unnamed: LED16.1 (R_A), R102.1
unnamed: LED16.3 (G_A), R101.1
unnamed: LED17.1 (R_A), R104.1
unnamed: LED17.3 (G_A), R103.1
unnamed: Q2.3 (D2), R82.1
unnamed: Q2.6 (D1), R81.1
unnamed: Q3.3 (D2), R84.1
unnamed: Q3.6 (D1), R83.1
unnamed: Q4.3 (D2), R86.1
unnamed: Q4.6 (D1), R85.1
unnamed: Q5.3 (D2), R88.1
unnamed: Q5.6 (D1), R87.1
unnamed: Q6.3 (D2), R106.1
unnamed: Q6.6 (D1), R105.1
unnamed: Q7.3 (D2), R108.1
unnamed: Q7.6 (D1), R107.1
unnamed: Q8.3 (D2), R110.1
unnamed: Q8.6 (D1), R109.1
unnamed: Q9.3 (D2), R112.1
unnamed: Q9.6 (D1), R111.1
unnamed: R57.2, U17.17 (ILIM)
unnamed: R58.2, U18.17 (ILIM)
unnamed: R59.2, U19.17 (ILIM)
unnamed: R60.2, U20.17 (ILIM)

Notes on the sheet:
ILIM: 3.06A
