rah1236/PCBGolf/(commit log)

2026-09-21 fix opamp wrong MPN bug
    [pcbgolf.kicad_pcb, pcbgolf_4.kicad_sch]
2026-09-24 Optimize KiCad schematics and compact component packages
    [pcbgolf.kicad_pcb, pcbgolf.kicad_sch, pcbgolf_2.kicad_sch, pcbgolf_3.kicad_sch, pcbgolf_4.kicad_sch, pcbgolf_5.kicad_sch]
